kgsully/MCU.ATMEGA328P-AU-Bootloader-PCB/README.md

# ATMEGA328P-AU Bootloader Burn PCB
 PCB to Burn Bootlader to Bare ATMEGA328P-AU Chips
 
 Please refer to the README docx or PDF found in the documentation folder for further information.
