kgsully/MCU.ATMEGA328P-AU-Bootloader-PCB/Base/Model/ATMega328P-AU Bootloader Burn Base.step

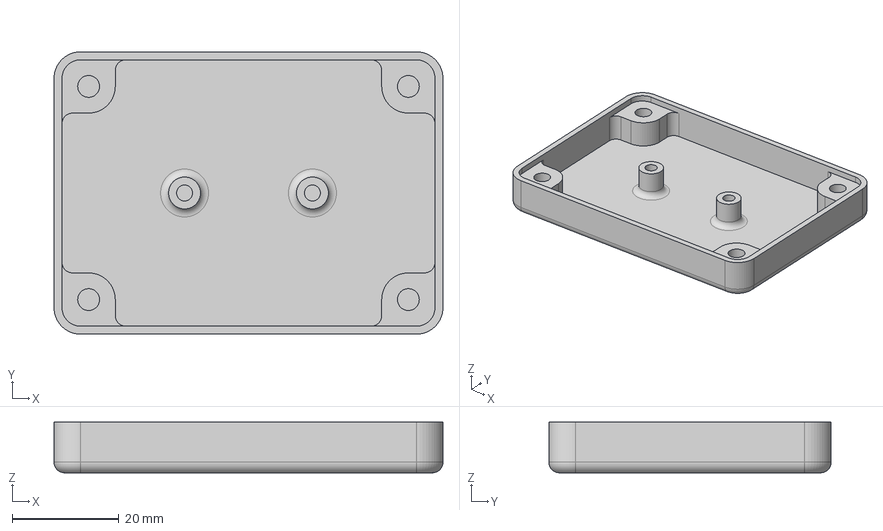
[picture p4: CAD file, 2023-03-25]
Base/Model/ATMega328P-AU Bootloader Burn Base.step
73.0 x 53.0 x 9.50 mm
