kgsully/MCU.ATMEGA328P-AU-Bootloader-PCB/(list of files, cad)

Other CAD files:
Base/3D Printing/Model/ATMega328P-AU Bootloader Burn Base.stl
Base/Model/ATMega328P-AU Bootloader Burn Base.f3d
