kgsully/MCU.ATMEGA328P-AU-Bootloader-PCB/Documentation/Drawings/Mechanical/ATMEGA328P-AU Bootloader Burn PCB Base Drawing.pdf

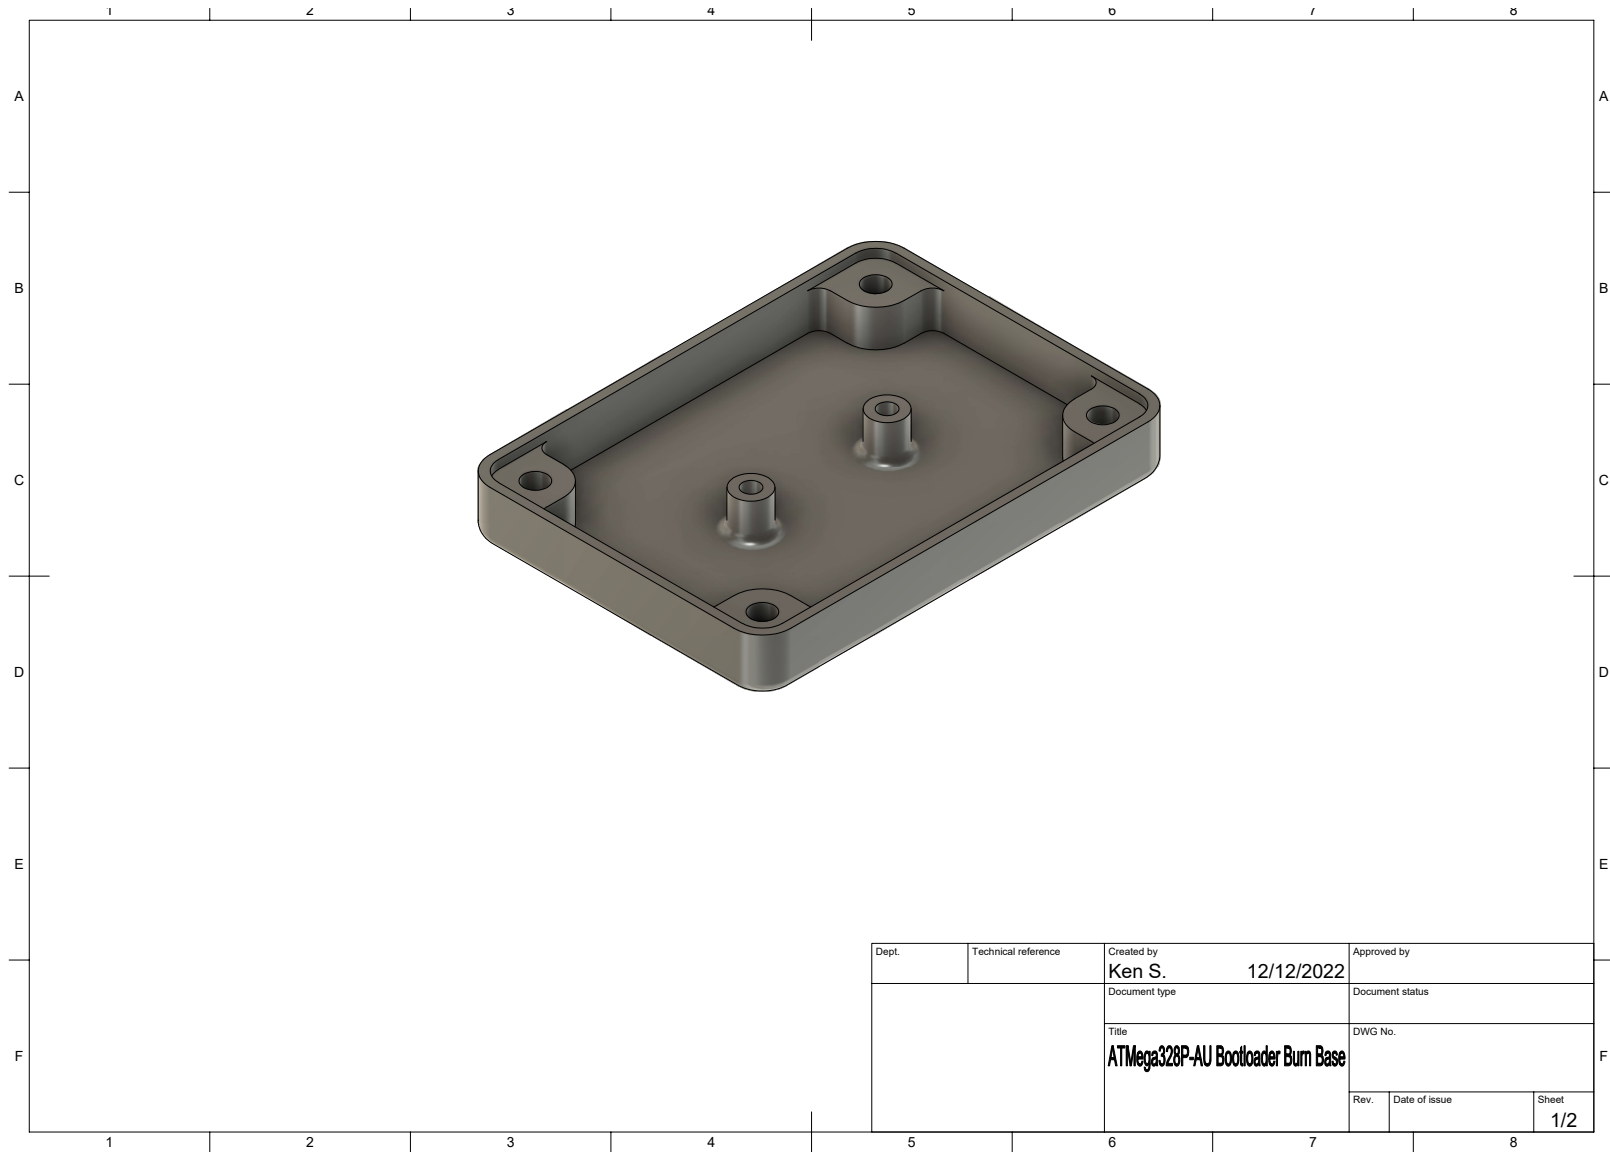
[picture p5: page 1]
8 BCDEF; ABCDEF Dept.; Technical reference; Created by; Approved by Document type; Document status Title; DWG No. Rev.; Date of issue; Sheet 12/12/2022; 1/2 Ken S.

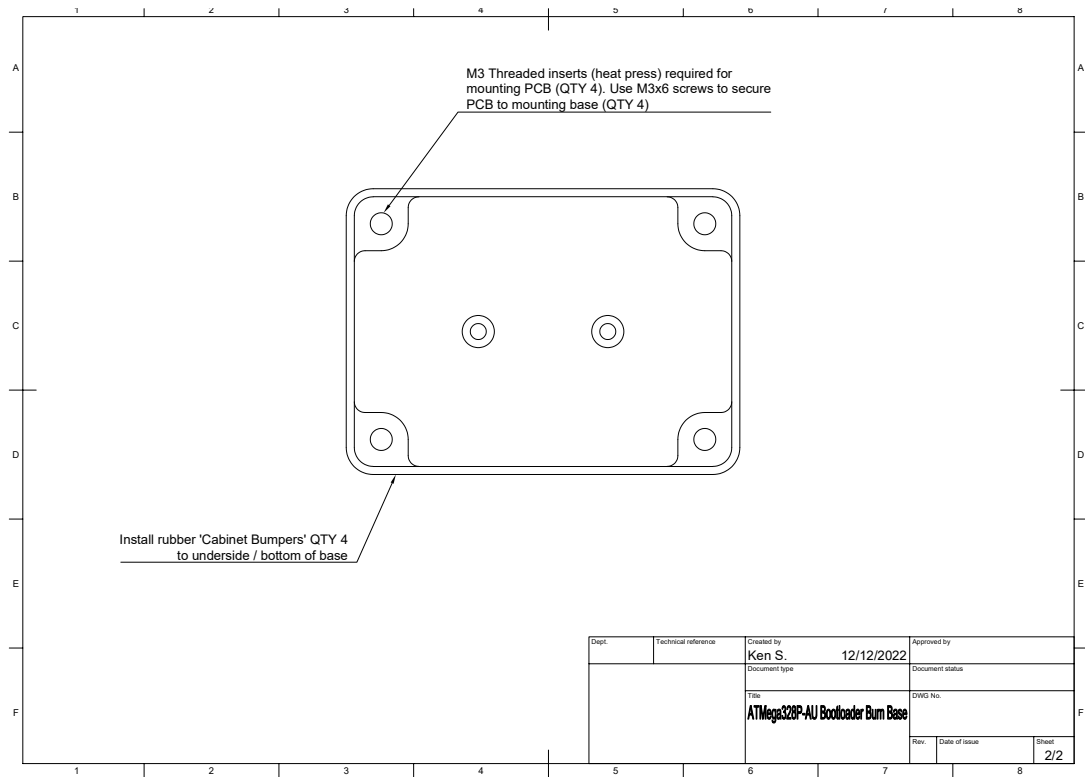
[picture p6: page 2]
8 BCDEF; ABCDEF Dept.; Technical reference; Created by; Approved by Document type; Document status Title; DWG No. Rev.; Date of issue; Sheet 12/12/2022; 2/2 Ken S. M3 Threaded inserts (heat press) required for mounting PCB (QTY 4). Use M3x6 screws to secure PCB to mounting base (QTY 4) Install rubber 'Cabinet Bumpers' QTY 4 to underside / bottom of base
