kgsully/MCU.ATMEGA328P-AU-Bootloader-PCB/Documentation/Drawings/Electrical/ATMEGA328P-AU Bootloader Burn PCB - Electrical Schematic.pdf

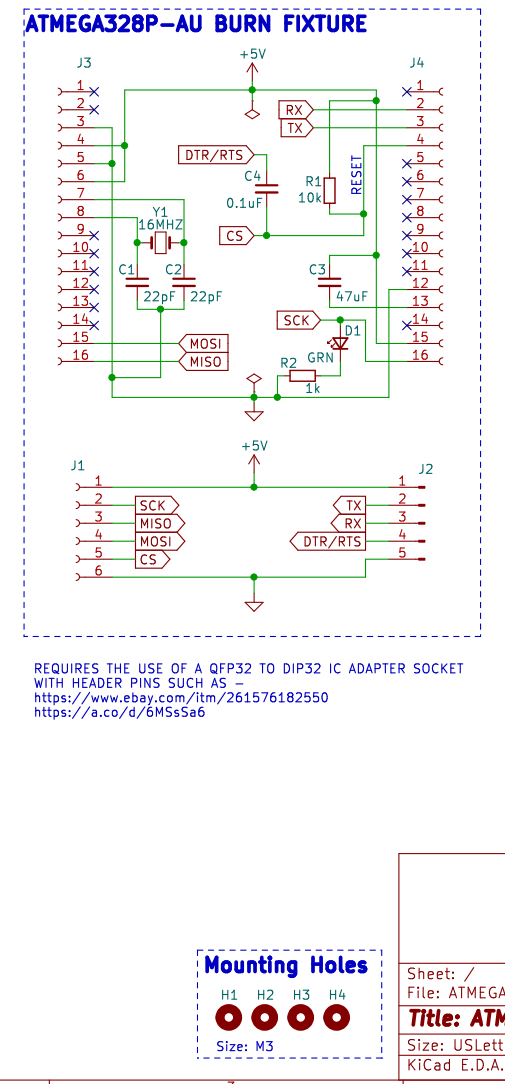
[picture p7: page 1]
