kgsully/MCU.ATMEGA328P-AU-Bootloader-PCB/Documentation/Drawings/Electrical/ATMEGA328P-AU Bootloader Burn PCB - PCB Layout.pdf

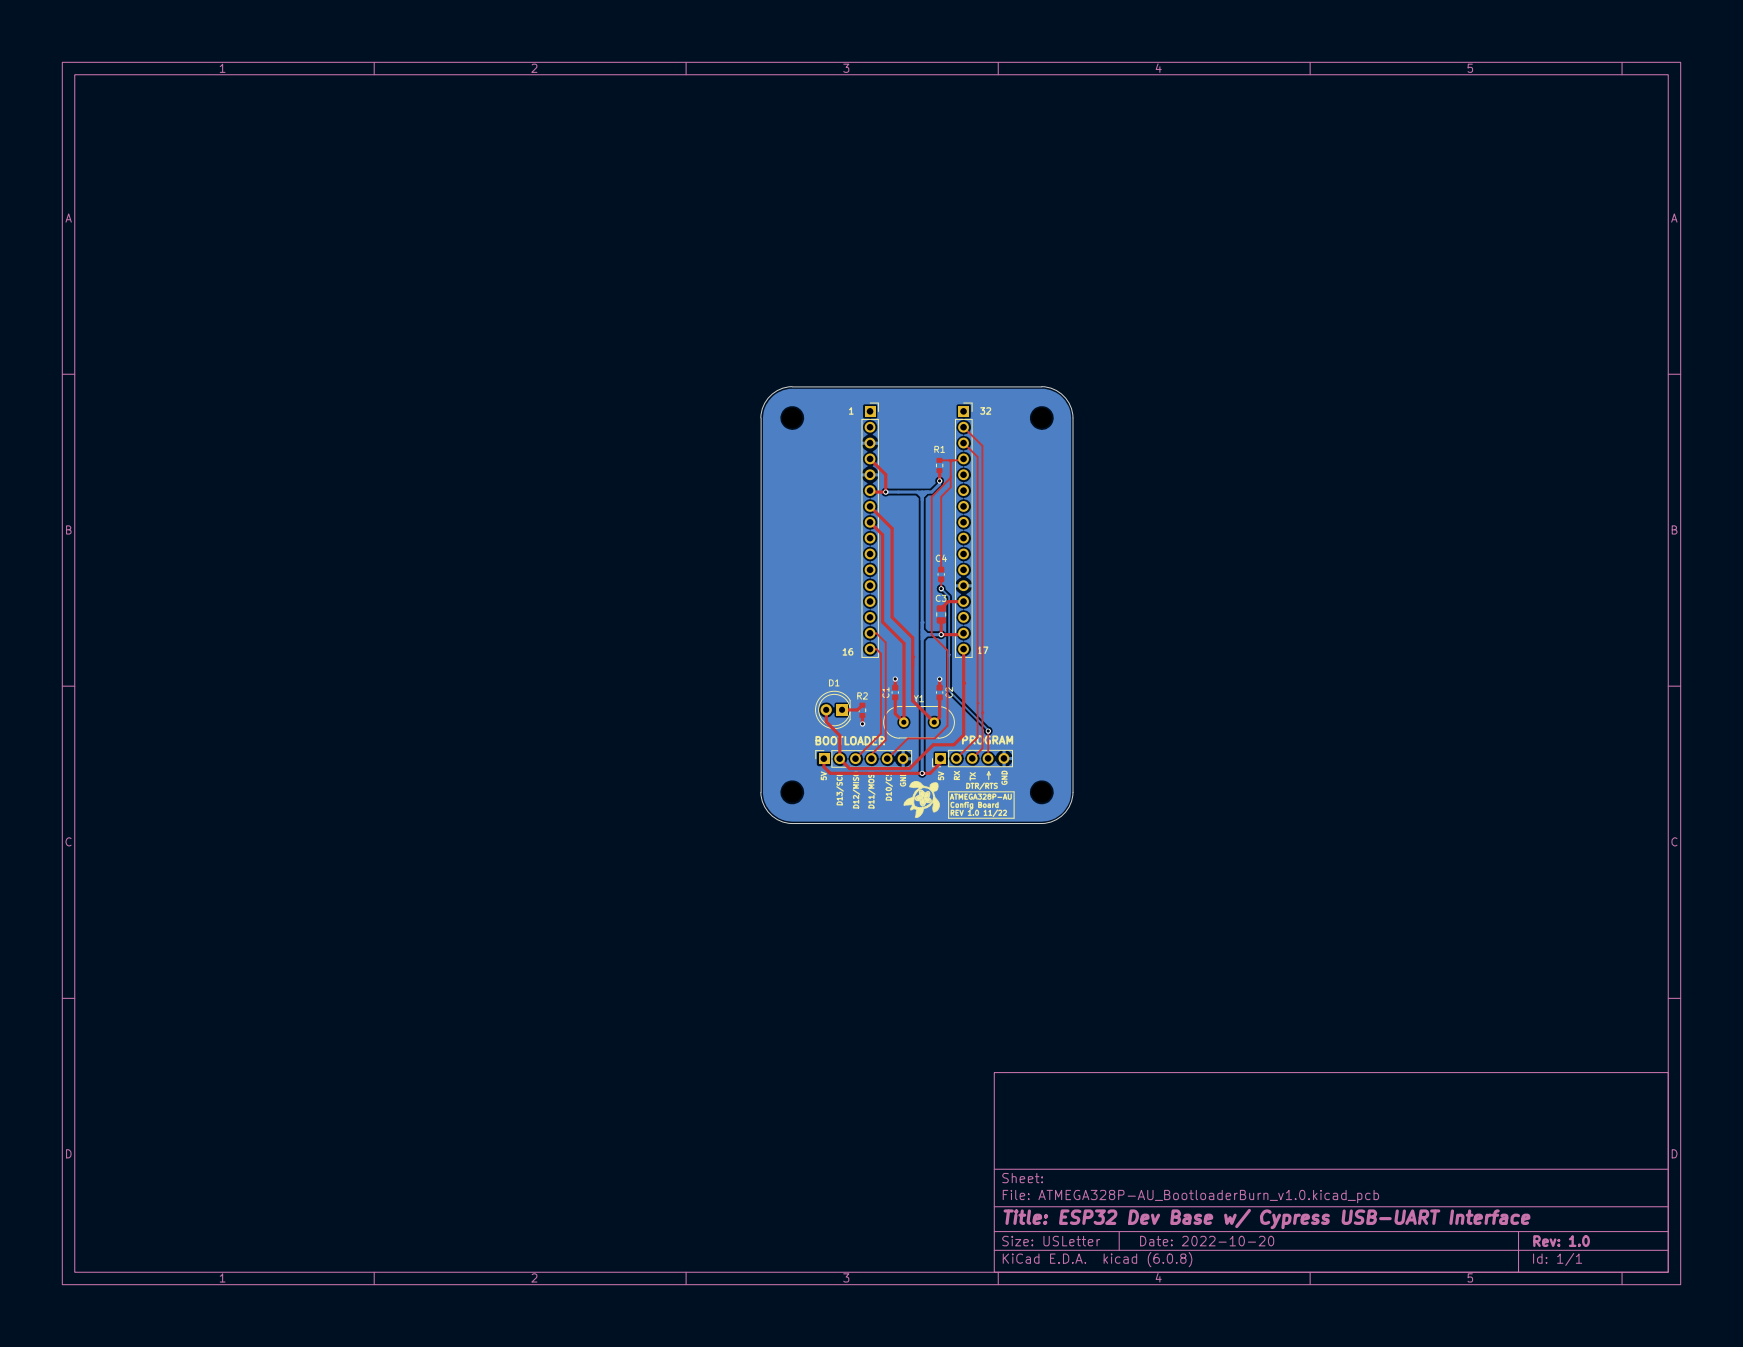
[picture p8: page 1]
