kgsully/MCU.ATMEGA328P-AU-Bootloader-PCB/Electrical & PCB/ATMEGA328P-AU_BootloaderBurn_v1.0.kicad_pcb

## KiCad design Electrical & PCB/ATMEGA328P-AU_BootloaderBurn_v1.0.kicad_pcb (2023-03-25)

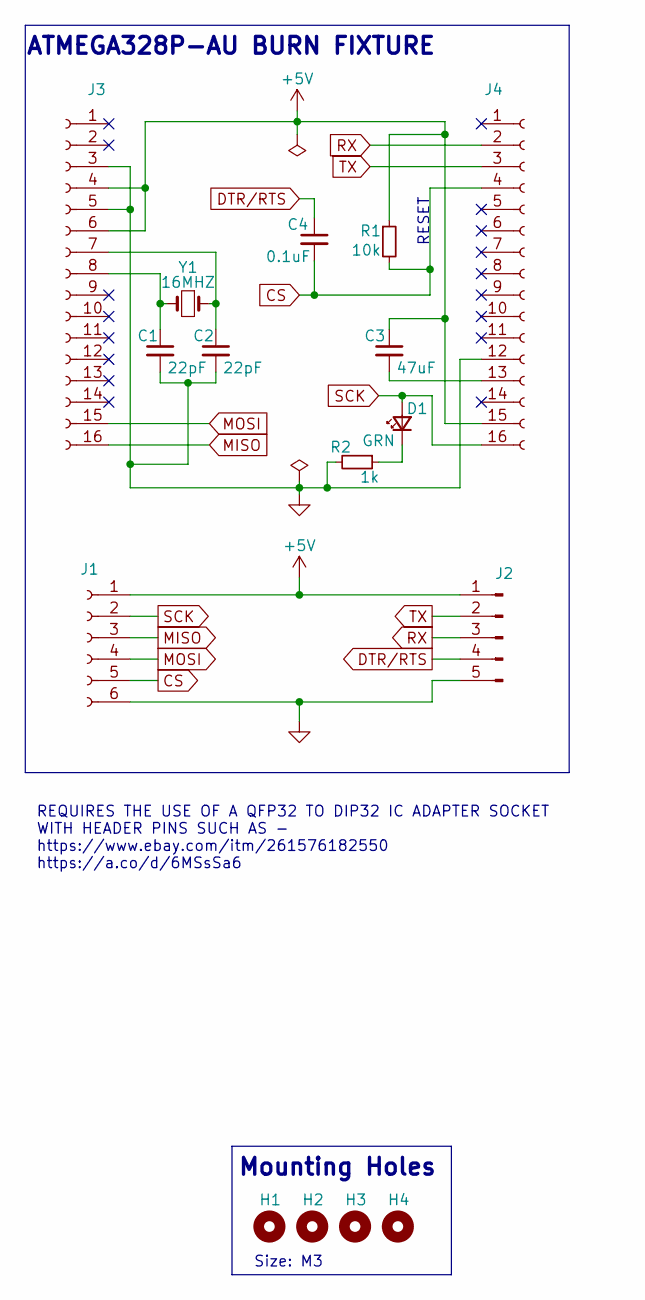
[picture p9: schematic ATMEGA328P-AU_BootloaderBurn_v1.0.kicad_sch, ATMEGTA328P-AU Burn Fixture]

Parts:
C1, C2: 22pF; C_0603_1608Metric
C3: 47uF; C_0805_2012Metric
C4: 0.1uF; C_0603_1608Metric
D1: GRN; LED_D5.0mm
H1, H2, H3, H4: MountingHole; MountingHole_3.2mm_M3
J1: Conn_01x06_Female; PinSocket_1x06_P2.54mm_Vertical
J2: Conn_01x05_Male; PinHeader_1x05_P2.54mm_Vertical
J3, J4: Conn_01x16_Female; PinSocket_1x16_P2.54mm_Vertical
R1: 10k; R_0603_1608Metric
R2: 1k; R_0603_1608Metric
Y1: 16MHZ; Crystal_HC49-U_Vertical

Connections:
+5V: C3.1, J1.1, J2.1, J3.4, J3.6, J4.15, R1.1
CS: C4.2, J1.5, J4.4, R1.2
DTR/RTS: C4.1, J2.4
GND: C1.2, C2.2, J1.6, J2.5, J3.3, J3.5, J4.12, R2.2
MISO: J1.3, J3.16
MOSI: J1.4, J3.15
unnamed: C1.1, J3.8, Y1.2
unnamed: C2.1, J3.7, Y1.1
unnamed: C3.2, J4.13
unnamed: D1.1 (K), R2.1
RX: J2.3, J4.2
SCK: D1.2 (A), J1.2, J4.16
TX: J2.2, J4.3

Notes on the sheet:
RESET
REQUIRES THE USE OF A QFP32 TO DIP32 IC ADAPTER SOCKET WITH HEADER PINS SUCH AS - https://www.ebay.com/itm/261576182550 https://a.co/d/6MSsSa6
ATMEGA328P-AU BURN FIXTURE
Mounting Holes
Size: M3

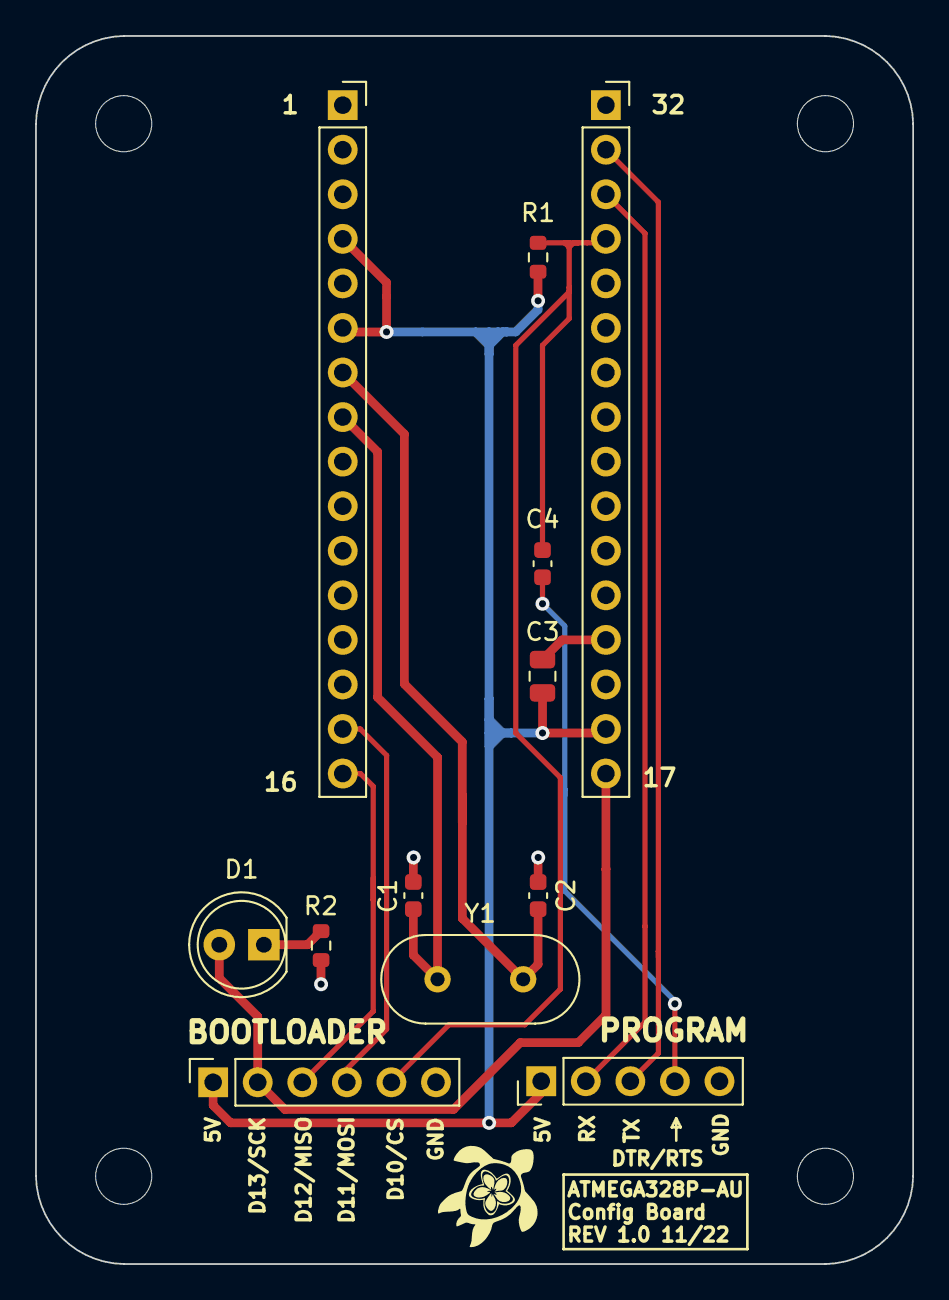
[picture p10: board ATMEGA328P-AU_BootloaderBurn_v1.0.kicad_pcb from above]

Board: 2 copper layers, 50.0 x 70.0 mm, 16 parts (0 on the bottom side), 13 nets.
